paramsaini87/riscv-cpu-gds2-flow/verif/tb_rv32i_cpu.v

// tb_rv32i_cpu.v — RV32IMAC 8-Stage CPU Testbench
// Instantiates rv32i_cpu with unified word-addressable memory.
// Loads test program via $readmemh, monitors TOHOST for pass/fail.

`timescale 1ns / 1ps

module tb_rv32i_cpu;

    // Clock and reset
    reg clk;
    reg rst_n;

    // CPU <-> memory wires
    wire [31:0] imem_addr, dmem_addr, dmem_wdata, imem_rdata, dmem_rdata;
    wire  [3:0] dmem_wstrb;
    wire        imem_req, dmem_req, imem_ready, dmem_ready;
    wire        dmem_lock;

    // New ports — directly accessible as wires
    wire        fence_i;
    wire        cpu_active;
    wire  [2:0] cpu_power_state;
    wire        debug_halted, debug_running;
    wire [31:0] debug_pc, debug_gpr_rdata;

    // Unified memory — 64KB (16K x 32-bit words)
    reg [31:0] mem [0:16383];

    // Initialize memory to zero (prevents X propagation from uninitialized locations)
    integer mem_init_i;
    initial for (mem_init_i = 0; mem_init_i < 16384; mem_init_i = mem_init_i + 1)
        mem[mem_init_i] = 32'h0;

    // TOHOST address: 0x1000 -> word index 0x400
    localparam TOHOST_WORD = 14'h400;

    // Clock: 10ns period (100 MHz)
    initial clk = 0;
    always #5 clk = ~clk;

    // Instruction memory — configurable latency
`ifdef IMEM_LATENCY
    reg [3:0] imem_wait_cnt;
    reg       imem_ready_r;
    assign imem_rdata = mem[imem_addr[15:2]];
    assign imem_ready = imem_ready_r;
    always @(posedge clk or negedge rst_n) begin
        if (!rst_n) begin
            imem_wait_cnt <= 0;
            imem_ready_r  <= 0;
        end else if (imem_req && !imem_ready_r) begin
            if (imem_wait_cnt >= `IMEM_LATENCY - 1) begin
                imem_ready_r  <= 1;
                imem_wait_cnt <= 0;
            end else
                imem_wait_cnt <= imem_wait_cnt + 1;
        end else begin
            imem_ready_r <= 0;
            imem_wait_cnt <= 0;
        end
    end
`else
    assign imem_rdata = mem[imem_addr[15:2]];
    assign imem_ready = 1'b1;
`endif

    // Data memory — configurable latency
`ifdef DMEM_LATENCY
    reg [3:0] dmem_wait_cnt;
    reg       dmem_ready_r;
    assign dmem_rdata = mem[dmem_addr[15:2]];
    assign dmem_ready = dmem_ready_r;
    always @(posedge clk or negedge rst_n) begin
        if (!rst_n) begin
            dmem_wait_cnt <= 0;
            dmem_ready_r  <= 0;
        end else if (dmem_req && !dmem_ready_r) begin
            if (dmem_wait_cnt >= `DMEM_LATENCY - 1) begin
                dmem_ready_r  <= 1;
                dmem_wait_cnt <= 0;
            end else
                dmem_wait_cnt <= dmem_wait_cnt + 1;
        end else begin
            dmem_ready_r <= 0;
            dmem_wait_cnt <= 0;
        end
    end
    always @(posedge clk) begin
        if (dmem_req && dmem_ready_r && |dmem_wstrb) begin
            if (dmem_wstrb[0]) mem[dmem_addr[15:2]][ 7: 0] <= dmem_wdata[ 7: 0];
            if (dmem_wstrb[1]) mem[dmem_addr[15:2]][15: 8] <= dmem_wdata[15: 8];
            if (dmem_wstrb[2]) mem[dmem_addr[15:2]][23:16] <= dmem_wdata[23:16];
            if (dmem_wstrb[3]) mem[dmem_addr[15:2]][31:24] <= dmem_wdata[31:24];
        end
    end
`else
    assign dmem_rdata = mem[dmem_addr[15:2]];
    assign dmem_ready = 1'b1;
    always @(posedge clk) begin
        if (dmem_req && |dmem_wstrb) begin
            if (dmem_wstrb[0]) mem[dmem_addr[15:2]][ 7: 0] <= dmem_wdata[ 7: 0];
            if (dmem_wstrb[1]) mem[dmem_addr[15:2]][15: 8] <= dmem_wdata[15: 8];
            if (dmem_wstrb[2]) mem[dmem_addr[15:2]][23:16] <= dmem_wdata[23:16];
            if (dmem_wstrb[3]) mem[dmem_addr[15:2]][31:24] <= dmem_wdata[31:24];
        end
    end
`endif

    // Timer interrupt for WFI testing
    reg timer_irq_r;
    initial timer_irq_r = 0;
`ifdef WFI_TIMER_CYCLES
    initial begin
        repeat(`WFI_TIMER_CYCLES) @(posedge clk);
        timer_irq_r = 1;
        repeat(10) @(posedge clk);
        timer_irq_r = 0;
    end
`endif

    // NMI pulse for NMI testing
    reg nmi_r;
    initial nmi_r = 0;
`ifdef NMI_CYCLES
    initial begin
        repeat(`NMI_CYCLES) @(posedge clk);
        nmi_r = 1;
        repeat(10) @(posedge clk);
        nmi_r = 0;
    end
`endif

    // External interrupt for vectored interrupt testing
    reg ext_irq_r;
    initial ext_irq_r = 0;
`ifdef EXT_IRQ_CYCLES
    initial begin
        repeat(`EXT_IRQ_CYCLES) @(posedge clk);
        ext_irq_r = 1;
        repeat(10) @(posedge clk);
        ext_irq_r = 0;
    end
`endif

    // Software interrupt for MSIP testing
    reg soft_irq_r;
    initial soft_irq_r = 0;
`ifdef SOFT_IRQ_CYCLES
    initial begin
        repeat(`SOFT_IRQ_CYCLES) @(posedge clk);
        soft_irq_r = 1;
        repeat(10) @(posedge clk);
        soft_irq_r = 0;
    end
`endif

    // Instruction memory error injection
    reg imem_error_r;
    initial imem_error_r = 0;
`ifdef IMEM_ERROR_CYCLES
    initial begin
        repeat(`IMEM_ERROR_CYCLES) @(posedge clk);
        imem_error_r = 1;
        repeat(10) @(posedge clk);
        imem_error_r = 0;
    end
`endif

    // DUT instantiation — 8-stage RV32IMAC CPU
    rv32i_cpu #(
        .RESET_ADDR(32'h0000_0000),
        .HART_ID(0),
        .NMI_ADDR(32'h0000_0004)
    ) dut (
        .clk            (clk),
        .rst_n          (rst_n),
        // Instruction memory
        .imem_addr      (imem_addr),
        .imem_req       (imem_req),
        .imem_rdata     (imem_rdata),
        .imem_ready     (imem_ready),
        .imem_error     (imem_error_r),
        // Data memory
        .dmem_addr      (dmem_addr),
        .dmem_wdata     (dmem_wdata),
        .dmem_wstrb     (dmem_wstrb),
        .dmem_req       (dmem_req),
        .dmem_lock      (dmem_lock),
        .dmem_rdata     (dmem_rdata),
        .dmem_ready     (dmem_ready),
        .dmem_error     (1'b0),
        // Interrupts
        .ext_irq        (ext_irq_r),
        .timer_irq      (timer_irq_r),
        .soft_irq       (soft_irq_r),
        .nmi            (nmi_r),
        // Debug — inactive
        .debug_halt     (1'b0),
        .debug_resume   (1'b0),
        .debug_halted   (debug_halted),
        .debug_running  (debug_running),
        .debug_pc       (debug_pc),
        .debug_gpr_addr (5'd0),
        .debug_gpr_wdata(32'd0),
        .debug_gpr_rdata(debug_gpr_rdata),
        .debug_gpr_wr   (1'b0),
        // Control outputs
        .fence_i        (fence_i),
        .cpu_active     (cpu_active),
        .cpu_power_state(cpu_power_state)
    );

    // Cycle counter
    integer cycle_count;

    // Test result detection
    reg test_done;
    reg test_pass;
    reg [31:0] tohost_val;

    // VCD dump
    initial begin
        $dumpfile("dump.vcd");
        $dumpvars(0, tb_rv32i_cpu);
    end

    // Load test program
    initial begin
`ifdef TEST_HEX
        $readmemh(`TEST_HEX, mem);
`else
        $display("ERROR: No TEST_HEX defined. Use -DTEST_HEX=\\\"file.hex\\\"");
        $finish;
`endif
    end

    // Reset sequence + main simulation loop
    initial begin
        rst_n = 0;
        test_done = 0;
        test_pass = 0;
        cycle_count = 0;
        tohost_val = 0;

        repeat (5) @(posedge clk);
        rst_n = 1;

        while (!test_done && cycle_count < 100000) begin
            @(posedge clk);
            cycle_count = cycle_count + 1;

            if (dmem_req && |dmem_wstrb && dmem_addr[15:2] == TOHOST_WORD) begin
                tohost_val = 0;
                if (dmem_wstrb[0]) tohost_val[ 7: 0] = dmem_wdata[ 7: 0];
                if (dmem_wstrb[1]) tohost_val[15: 8] = dmem_wdata[15: 8];
                if (dmem_wstrb[2]) tohost_val[23:16] = dmem_wdata[23:16];
                if (dmem_wstrb[3]) tohost_val[31:24] = dmem_wdata[31:24];
                test_done = 1;
                test_pass = (tohost_val == 32'd1);
            end
        end

        if (!test_done) begin
            $display("TIMEOUT after %0d cycles", cycle_count);
            dump_regs();
            $finish(1);
        end else if (test_pass) begin
            $display("PASS (%0d cycles)", cycle_count);
            $finish(0);
        end else begin
            $display("FAIL: tohost = %0d (%0d cycles)", tohost_val, cycle_count);
            dump_regs();
            $finish(1);
        end
    end

    // Register dump on failure/timeout
    task dump_regs;
        integer i;
        begin
            $display("--- Register File ---");
            for (i = 0; i < 32; i = i + 1)
                $display("  x%-2d = 0x%08h", i, dut.regfile[i]);
            $display("--- Pipeline State ---");
            $display("  PC          = 0x%08h", dut.pc);
            $display("  imem_addr   = 0x%08h", imem_addr);
            $display("  dmem_addr   = 0x%08h", dmem_addr);
        end
    endtask

endmodule
