paramsaini87/riscv-cpu-gds2-flow/(commit log)

2026-04-01 RV32I CPU — SKY130 RTL-to-GDSII (LibreLane 3.0.1)
2026-04-09 Add verification & formal equivalence section — 92/92 ISA tests, V1/V2/V3 formal proof, multi-corner STA, DRC/LVS clean signoff
2026-04-10 Add RV32C/A/WFI verification tests with compressed instruction assembler support
    - rv32i_asm.py: Add 16-bit compressed instruction encoding (RV32C)
    - New emit types: c16, cb, cj for 16/branch/jump compressed instrs
    - Add creg() for compressed register mapping (x8-x15 -> 0-7)
    - Add _encode_cj_offset/_encode_cb_offset for branch/jump offsets
    - Add all RV32C instructions: C.LI, C.ADDI, C.LUI, C.NOP, C.SLLI,
    C.SRLI, C.SRAI, C.ANDI, C.SUB/XOR/OR/AND, C.MV, C.ADD, C.J,
    C.JAL, C.JR, C.JALR, C.BEQZ, C.BNEZ, C.LW, C.SW, C.LWSP,
    C.SWSP, C.ADDI16SP, C.ADDI4SPN, C.EBREAK
    - Add ALIGN4() method for word-boundary padding (C.NOP)
    - Modify assemble() for mixed 16/32-bit instruction pa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
2026-04-10 8-stage RV32IMAC: Bug #8 fix, 10 gap tests, 84/84 pass
    - Fixed PMP NA4 address comparison (Bug #8): csr_pmpaddr[i][31:2] -> [29:0]
    - Added 10 gap-coverage tests: soft_irq, pmp_na4, nested_exception,
    nmi_during_irq, imem_error, sc_fail, pmp_unlocked, csri_zero,
    c_halfword_align, hpm_verify
    - Testbench: connected soft_irq_r + imem_error_r (were hardcoded 1'b0)
    - run_tests.sh: added compile defines for new interrupt/error tests
    - Preserved 5-stage RTL as rv32i_cpu_v1_5stage.v for reference
    - All 84 verification tests PASS
    [gen_tests.py, rv32i_cpu.v, rv32i_cpu_v1_5stage.v, tb_rv32i_cpu.v]
2026-04-10 I-fetch PMP check, HPM defaults, 3 gap tests — 87/87 pass
    RTL fixes:
    - Add I-fetch PMP: combinational check on if1_if2_pc for execute (X) permission
    across all 16 PMP regions (TOR/NA4/NAPOT), faults as EXC_INSTR_FAULT (mcause=1)
    - HPM event defaults: mhpmevent3=1 (misprediction), mhpmevent4=2 (stall)
    New tests:
    - test_ifetch_pmp: PMP TOR locked no-X region, verify instruction access fault
    - test_ext_irq: external interrupt MEIP handling (mcause=0x8000000B)
    - test_c_addi4spn: C.ADDI4SPN with 4 scaled immediates
    Testbench:
    - Initialize memory to zero (prevent X propagation from uninitialized addresses)
    - Add EXT_IRQ_CYCLES compile define for external interrupt test
    [gen_tests.py, rv32i_cpu.v, tb_rv32i_cpu.v]
2026-04-10 Fix pipeline stall bugs causing failures with memory latency
    Two root-cause bugs in the 8-stage pipeline stall handling:
    1. IF1/IF2 duplicate instruction execution (fetch_stall):
    When imem has latency, fetch_stall freezes IF1/IF2 (via pc_stall) but
    IF2/ID was NOT frozen (if2_stall only checked hazard_stall). This caused
    IF2 to re-consume the same instruction from IF1/IF2 every cycle, executing
    every instruction twice. Fix: invalidate if1_if2_valid after IF2 consumes
    the instruction while PC is stalled, unless IF2 is processing from its
    held buffer (compressed instruction alignment).
    2. SC (Store Conditional) deadlock with dmem latency:
    a) mem_stall included failed SC w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
    [rv32i_cpu.v]
2026-04-10 fix: 8-stage pipeline stall bug — prevent instruction re-execution during fetch stalls
    Root cause: when fetch_stall=1 (imem not ready), IF1→IF2 register was frozen
    but if1_if2_valid stayed at 1. IF2→ID was not gated by fetch_stall, causing
    the same instruction to be re-consumed and executed multiple times.
    Fix: added if2_fetched 1-bit register that tracks whether IF2→ID has already
    consumed the current IF1→IF2 data. Gates if1_if2_valid via if1_if2_valid_eff
    in all 6 IF2 processing signal computations. Held buffer (compressed instr)
    path is unaffected — only fresh-fetch consumption is gated.
    Also relaxed HPM load-use stall counter tests for stall mode tolerance
    (fetch l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
    [gen_tests.py]
